BeeTee-EmBed/Icarus/Final Design (Icarus2019)/PCB Layout with traces.JPG

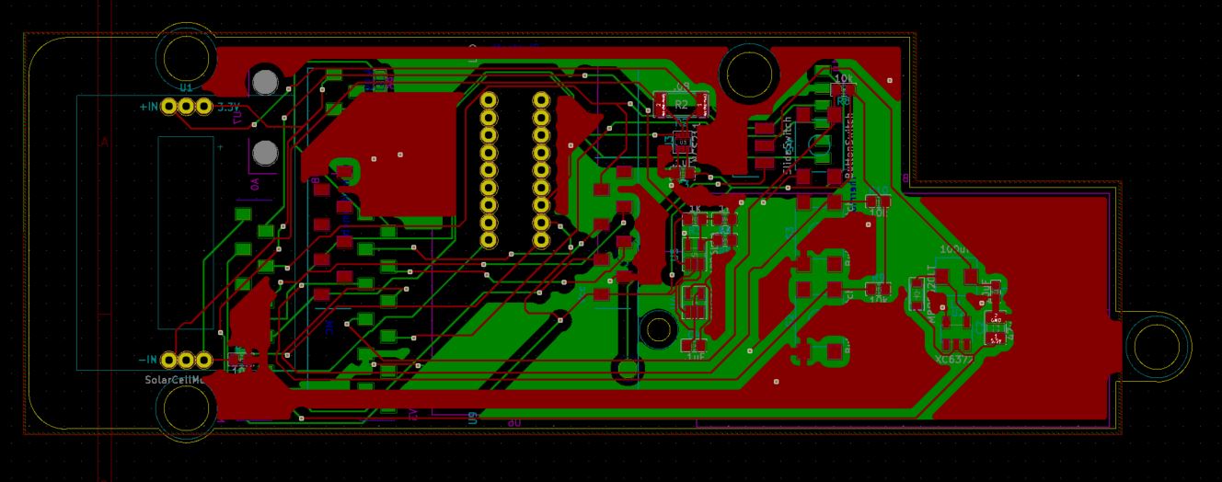
Final Design (Icarus2019)/PCB Layout with traces.JPG
