BeeTee-EmBed/Icarus/Final Design (Icarus2019)/3D view top.JPG

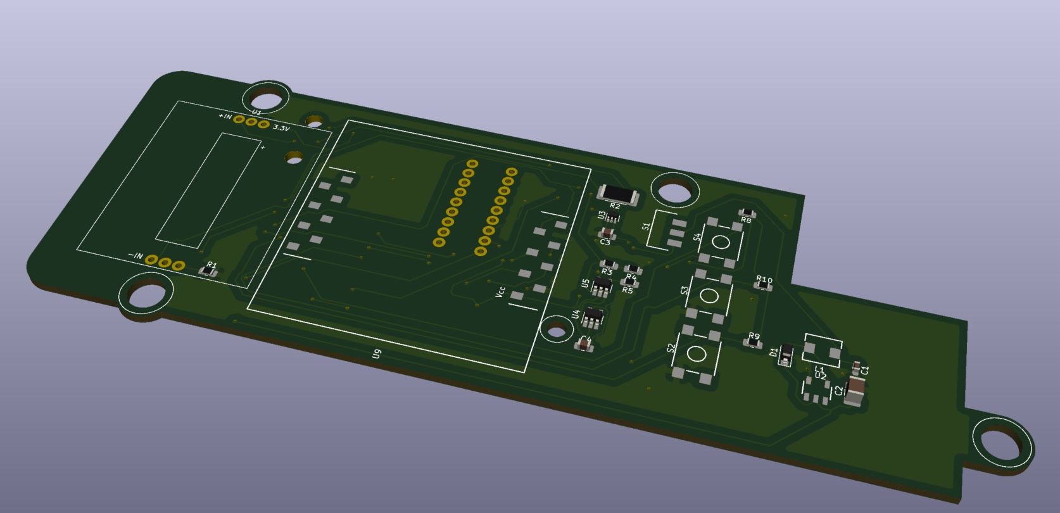
Final Design (Icarus2019)/3D view top.JPG
