BeeTee-EmBed/Icarus/Pin Out Specifications.xlsx

Accelerometer Pins | SDA -> D0
 | SDA -> D1
LCD Display | SCE -> A2
 | CLK -> A3
 | MOSI -> A5
 | D/C -> D2
 | RST -> D3
 | LED -> NA
 | Vcc -> 3V3
 | GND -> GND
Thermistor | Analog -> A0
Temp Sensor | Analog -> A1
Reference Cell | Analog -> DAC/A6
Thermocouple | CS -> WKP/A7
 | CLK -> A3
 | DO/MISO -> WKP
Buttons
Main | Digital -> D4
Temperature | Digital -> D5
Max/Angle | Digital -> D6
