BeeTee-EmBed/Icarus/Final Design (Icarus2019)/Icurus Error Analysis.xls

Sheet: 1 YEAR ANALYSIS
IRRADIANCE METER 1 YEAR ERROR ANALYSIS |  |  |  |  |  |  | 2019-08-07 |  | "STATISTICS IS NEVER HAVING TO SAY YOU'RE CERTAIN"
/evtfs/nfswkgrp/grponly/lepton/electrical/HRS/LEPTONerroranalysis.xls
ERROR MAGNITUDES ARE IN MAXIMUM +/-PPM EXCEPT WHERE NOTED IN RED ITALICS. MAXIMUM ERRORS ARE ROOT SUM SQUARED.
RED ITALICS | = | TYPICAL ERROR MAGNITUDES WHICH ARE ADDED TO THE ROOT SUM SQUARED ERRORS
 | = | PPM PER ROOT MONTH
 |  | INACCURACY |  | 12
 |  | OR NON- | TC | MONTH |  |  | Irradiance | Cell Temp | Ambien Temp | Inclinometer | Panel Temp
ERROR SOURCES |  | LINEARITY | PER DEG | STABILITY | HUMIDITY
VOLTAGE REFERENCE
REFERENCE |  | 30000 | 100 |  |  |  | 1 | 1 | 1 | 0 | 0
HYSTERESIS |  |  |  |  |  |  | 1 | 1 | 1 | 0 | 0
LOAD REGULATION/mA |  |  |  |  |  |  | 1 | 1 | 1 | 0 | 0
A/D CONVERTER
A/D CONVERTER |  | 1220 |  |  |  |  | 1 | 1 | 1 | 0 | 0
SOLAR CELL
Isc |  |  |  |  |  |  | 1 | 0 | 0 | 0 | 0
Temperature Coeffient |  |  |  |  |  |  | 1 | 0 | 0 | 0 | 0
SHUNT RESISTOR
80m ohms |  | 10000 | 50 | 200 | 400 |  | 1 | 0 | 0 | 0 | 0
INCLINOMETER
Angle Measurement |  | 26400 |  |  |  |  | 0 | 0 | 0 | 1 | 0
CURRENT SHUNT MONITOR
Gain 500 |  | 10000 | 10 |  |  |  | 1 | 0 | 0 | 0 | 0
 |  |  |  |  |  |  | 0 | 0 | 0 | 0 | 0
THERMISTOR
Resistance |  | 10000 |  |  |  |  | 1 | 1 | 0 | 0 | 0
B |  | 10000 |  |  |  |  | 1 | 1 | 0 | 0 | 0
THERMISTOR SERIES RESISTANCE
10k |  | 10000 | 100 | 200 | 400 |  | 1 | 1 | 1 | 0 | 0
TEMPERATURE SENSOR
Ambient Temperature |  | 160000 |  |  |  |  | 0 | 0 | 1 | 0 | 0
TEMPERATURE GAIN
R3 |  | 10000 | 100 | 200 | 400 |  | 0 | 0 | 1 | 0 | 0
R4 |  | 10000 | 100 | 200 | 400 |  | 0 | 0 | 1 | 0 | 0
R5 |  | 10000 | 100 | 200 | 400 |  | 0 | 0 | 1 | 0 | 0
THERMOCOUPLE
Panel Temperature |  |  |  |  |  |  | 0 | 0 | 0 | 0 | 1
INSTRUMENT CAPABILITY AT ONE |  |  |  |  | TEMPERATURE SHIFT | 10
YEAR AT 23+/-5 DEG C |  |  | ERRORS: |  |  | SUM | 8.50% | 6.38% | 24.01% | ±2.64% | ±2°C
 |  |  |  |  |  | RSS | 4.61% | 3.47% | 16.61%

Sheet: ERROR SOURCES
LEPTON ERROR ANALYSIS ERROR SOURCES
/evtfs/nfswkgrp/grponly/lepton/electrical/HRS/LEPTONerroranalysis.xls
 | PARAMETER | SOURCE
VOLTAGE REFERENCE | TC | LEO SPEC
 | STABILITY | 1 YEAR LEO TESTING
 | HYSTERESIS | LEO SPEC
 | LOAD REGULATION/mA | LEO SPEC
A/D CONVERTER | NON-LINEARITY | LEO SPEC
 | TC | LEO SPEC
SOLAR CELL | TC | Z1 SPEC
 | STABILITY | Z1 SPEC
 | HUMIDITY | Z1 SPEC
 | Temperature Coeffient | Z1 SPEC
SHUNT RESISTOR | TC | RESISTOR SPEC
 | STABILITY | BEN ENG'S 1 YEAR STABILITY TEST
 | HUMIDITY | HUMIDITY TEST
 | INCLINOMETER | Characterized, see lepton/electrical/freqresp/Rev5FreqResp.xls
 | Angle Measurement | Characterized, see lepton/electrical/freqresp/Rev5FreqResp.xls
CURRENT SHUNT MONITOR | NON-LINEARITY | LEO SPEC
 | TC | LEO SPEC
 | 0 | LEO SPEC
THERMISTOR | NON-LINEARITY | LEO SPEC
 | TC | LEO SPEC
 | STABILITY | 1 YEAR LEO TESTING
THERMISTOR SERIES RESISTANCE
10k | TC | RESISTOR SPEC
 | STABILITY | HISTORICAL & VENDOR TESTING
 | HUMIDITY | HISTORICAL & VENDOR TESTING
0 | TC | TESTING A MIZER SHUNT
 | STABILITY | AN ESTIMATE
 | 0 | TESTING A MIZER SHUNT
 | 0 | TESTING A MIZER SHUNT
TEMPERATURE SENSOR | NON-LINEARITY & TC | LEO SPEC
 | STABILITY | 1 YEAR LEO TESTING
TEMPERATURE GAIN | TC | LEO SPEC
 | STABILITY | 1 YEAR LEO TESTING
0 | TC | RESISTOR SPEC
 | STABILITY | BEN ENG'S 1 YEAR STABILITY TEST
 | HUMIDITY | HUMIDITY TEST
0 |  | VALIDARE TESTING

Sheet: MOHMS SENSITIVITY
LEPTON MOHMS SENSITIVITY | 20JUL05
/evtfs/nfswkgrp/grponly/lepton/electrical/HRS/LEPTONerroranalysis.xls
 |  | PPM |  | PPM |  | PPM
 |  | SHIFT |  | SHIFT |  | SHIFT
40 M OHMS
Is | 1e-07 | 1000 | 1.001e-07 | 0 | 1e-07 | 0 | 1e-07
Z1.10M NOMINAL | 10000000 | 0 | 10000000 | 1000 | 10010000 | 0 | 10000000
S64 NOMINAL | 1000 | 0 | 1000 | 0 | 1000 | 1000 | 1001
10M=Z1.10M+S64 | 10001000 |  | 10001000 |  | 10011000 |  | 10001001
Rx | 0 |  | 0 |  | 0 |  | 0
Vo=Is*Rx*(10M+S64)/(Rx+10M+S64) | 0.00000 |  | 0.00000 |  | 0.00000 |  | 0.00000
Vo, Rx+10k | 0.00100
uV/COUNT | 999.0
Rx=Vo*10M/(Is*10M-Vo) | 0 |  | 0 |  | 0 |  | 0
ERROR IN PPM |  |  | #DIV/0! |  | #DIV/0! |  | #DIV/0!
SENSITIVITY RATIO |  |  | #DIV/0! |  | #DIV/0! |  | #DIV/0!
