BeeTee-EmBed/Icarus/Final Design (Icarus2019)/3D view bottom.JPG

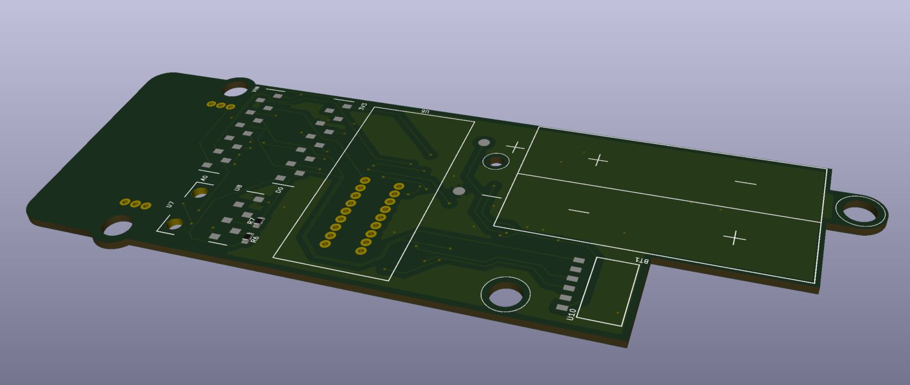
Final Design (Icarus2019)/3D view bottom.JPG
