BeeTee-EmBed/Icarus/Final Design (Icarus2019)/Case.png

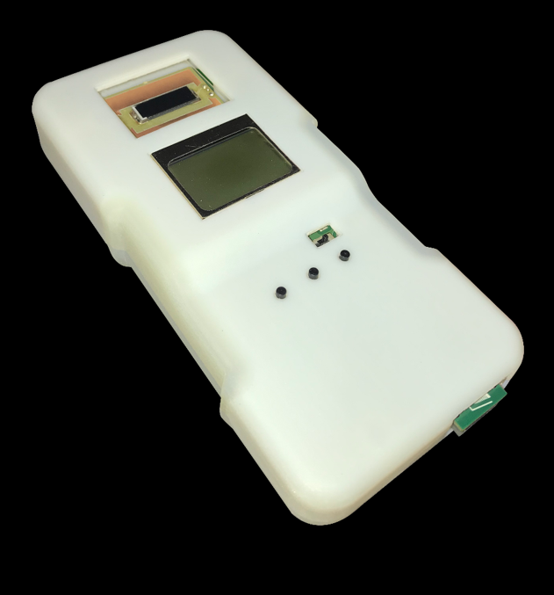
Final Design (Icarus2019)/Case.png
