BeeTee-EmBed/Icarus/Final Design (Icarus2019)/KiCad Schematic.JPG

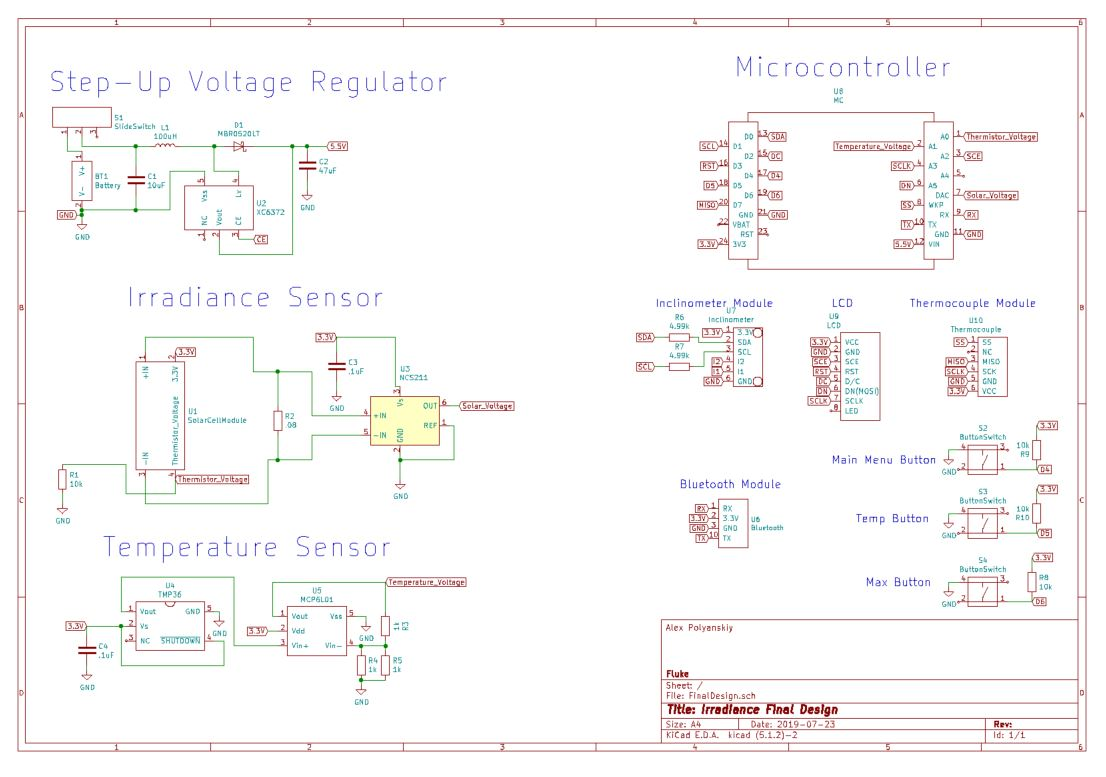
Final Design (Icarus2019)/KiCad Schematic.JPG
