BeeTee-EmBed/Icarus/Final Design (Icarus2019)/PCB Layout.JPG

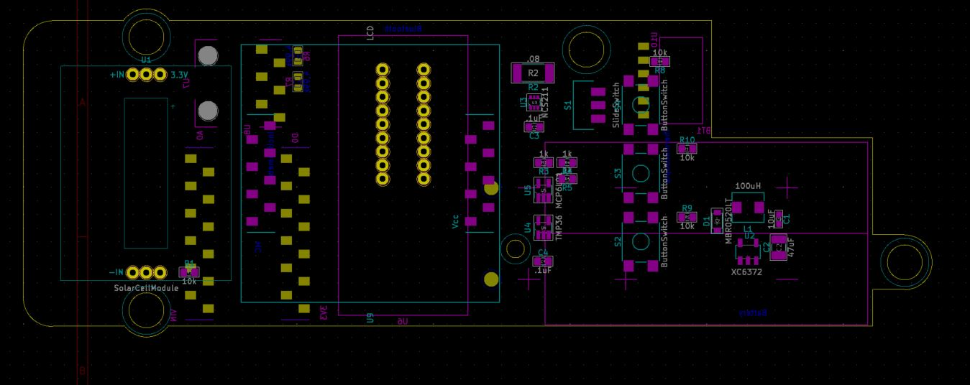
Final Design (Icarus2019)/PCB Layout.JPG
