BeeTee-EmBed/Icarus/First Design/Screenshots/3D PCB Layout.PNG

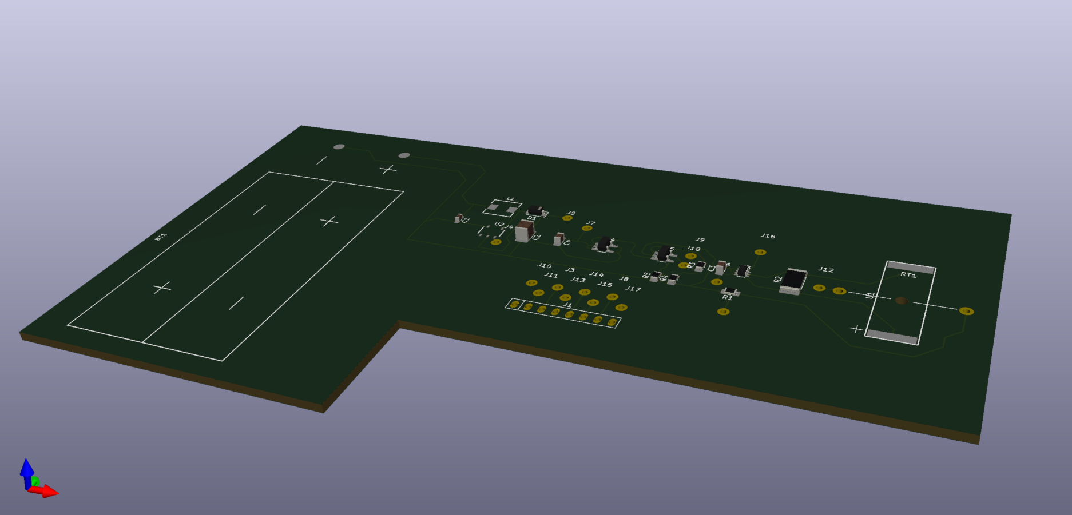
First Design/Screenshots/3D PCB Layout.PNG
