BeeTee-EmBed/Icarus/First Design/Screenshots/Built Circuit.jpg

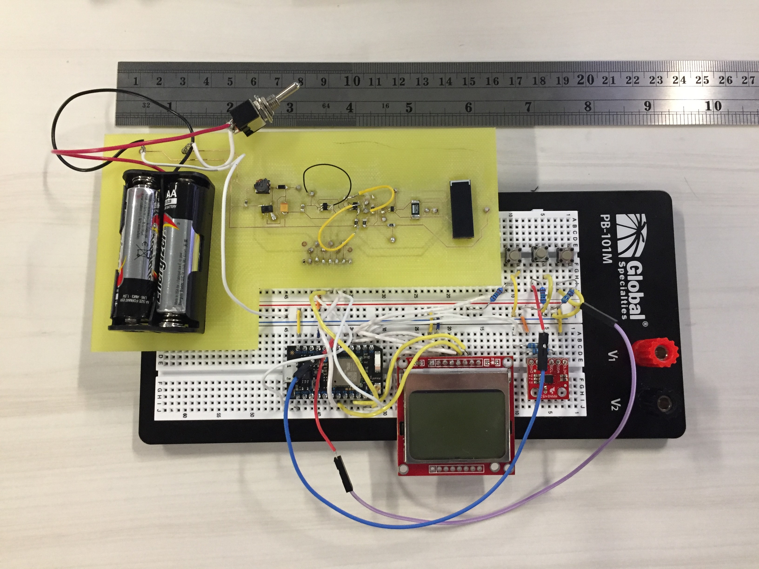
First Design/Screenshots/Built Circuit.jpg
