BeeTee-EmBed/Icarus/First Design/Screenshots/PCB Layout.PNG

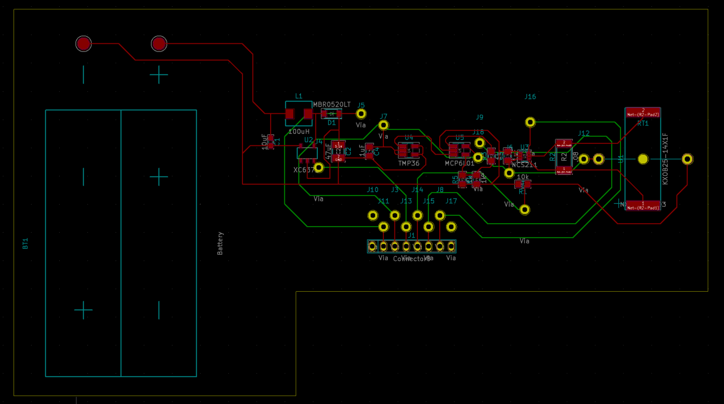
First Design/Screenshots/PCB Layout.PNG
