BeeTee-EmBed/Icarus/First Design/Screenshots/Prototype Schematic.PNG

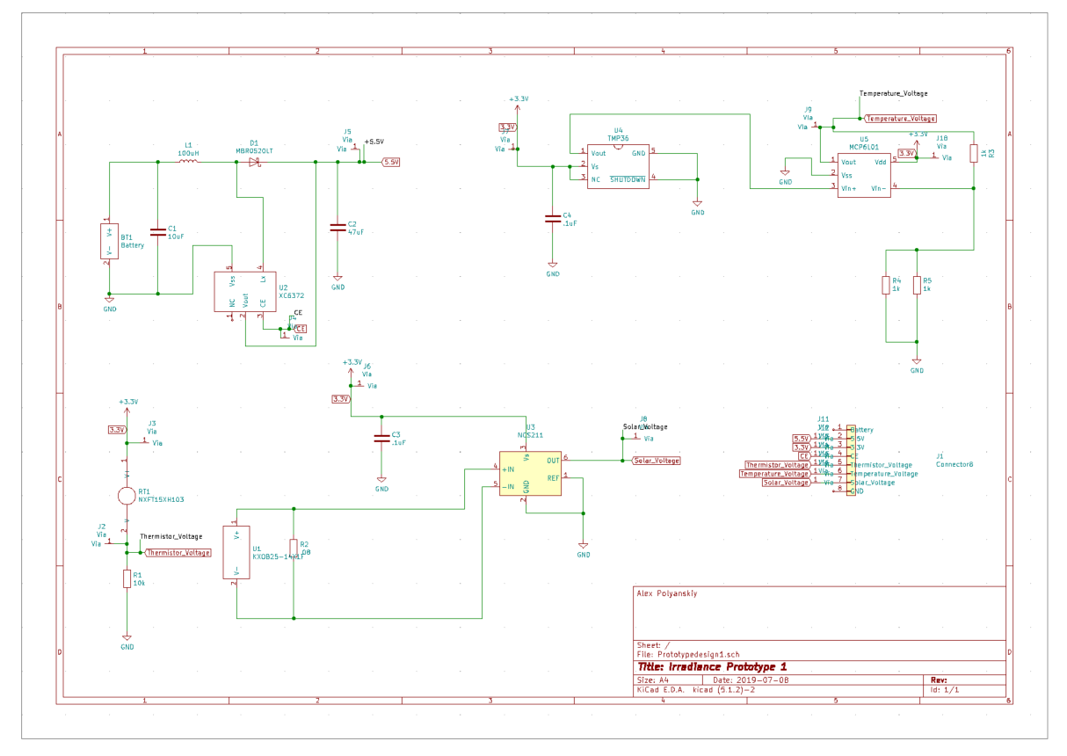
First Design/Screenshots/Prototype Schematic.PNG
