BeeTee-EmBed/Icarus/Irradiance Questions Answered by IEC/Email 1.JPG

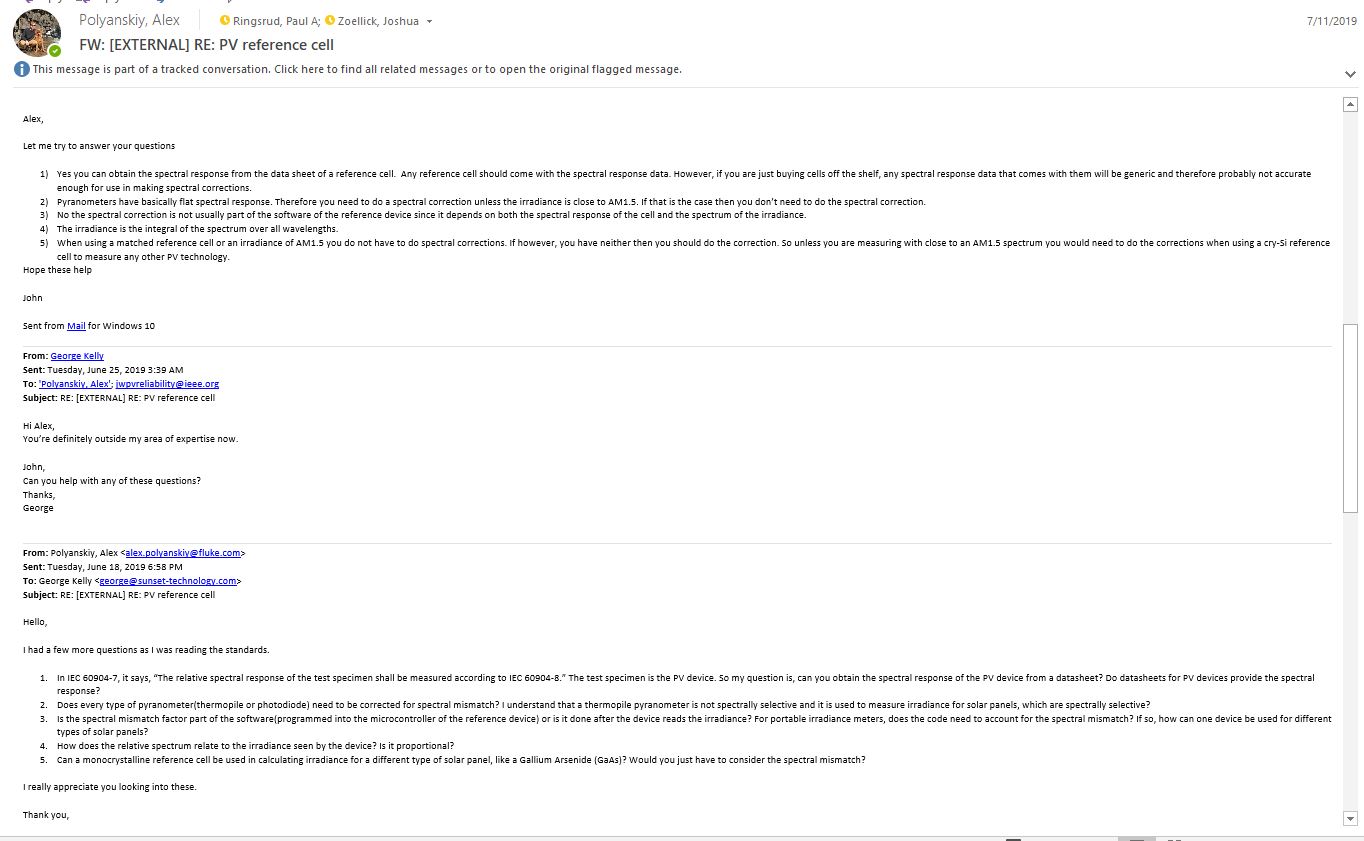
Irradiance Questions Answered by IEC/Email 1.JPG
