BeeTee-EmBed/Icarus/Irradiance Questions Answered by IEC/Email 2.JPG

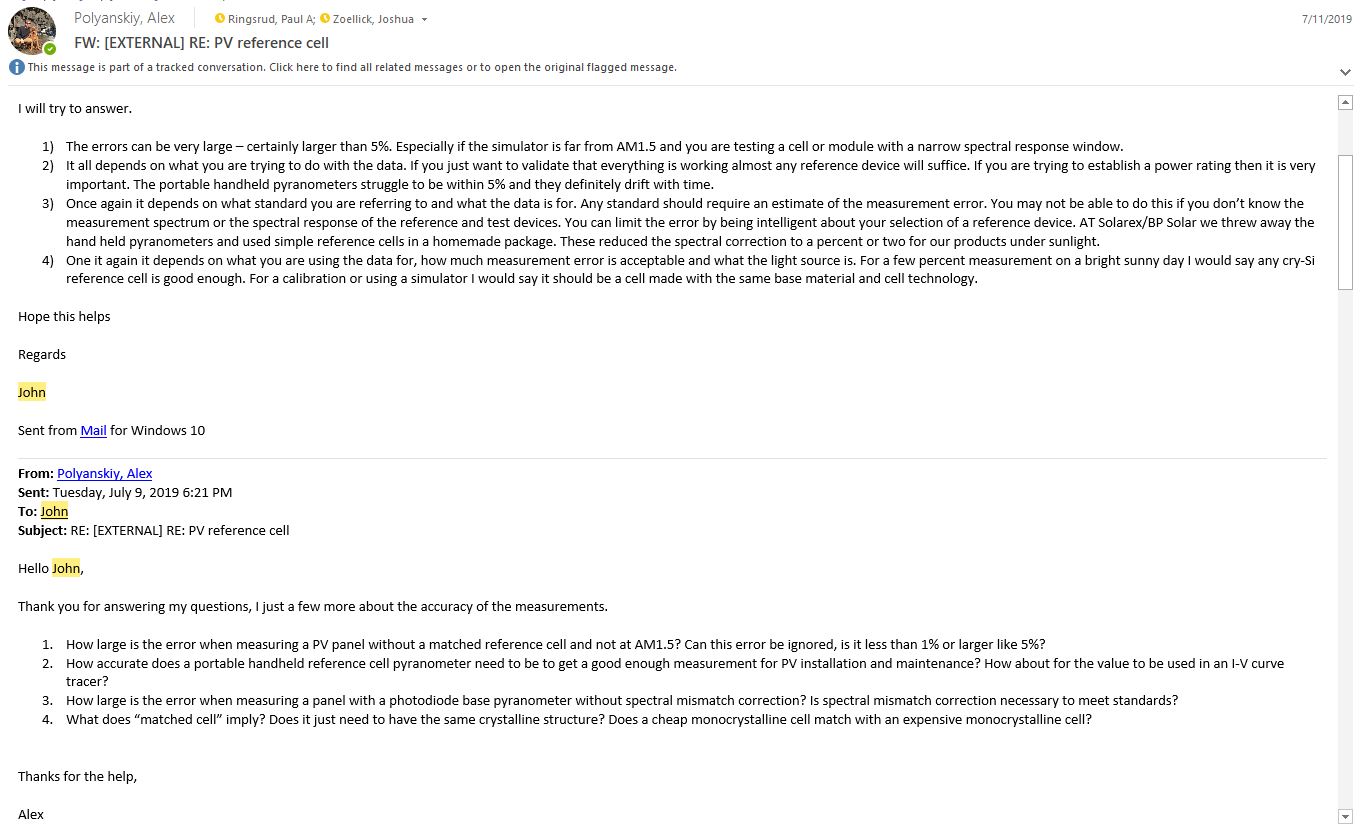
Irradiance Questions Answered by IEC/Email 2.JPG
