BeeTee-EmBed/Icarus/HardwareCost.xlsx

Part | Datasheet | Application | Cost | Quantity | Specs | Purchase Site | Note | Operating Current (mA) | Equations
KXOB25-14X1F-ND | Reference Cell Datasheet (http://ixapps.ixys.com/DataSheet/KXOB25-14X1F.pdf) | Solar Cell | $2.03 | 1 | Isc: 58mA Voc: 690mV Vmpp: 560mV Impp: 55mA Pmpp: 30.7mW FF: >70% Efficiency:25% Voc temp coefficient: -1.7 mV/K Isc temp coefficient: 26.5 uA/K | Digi-Key (https://www.digikey.com/product-detail/en/ixys/KXOB25-14X1F-TR/KXOB25-14X1FCT-ND/9990482) |  |  | Ee = effective irradiance Es = irradiance at standard conditions (1000w/m^2) Isc = measured short cicuit current Tc = cell temperature (found through thermistor) To = reference temperature (25 C) α = temperature coefficient for Isc (26.5 uA/C) Isco = reference short circuit current (58.6 mA)
BK7 glass | escooptics (https://escooptics.com/products/windows-commercial-quality-square-bk7-optical-glass?variant=19494881603) | Protective window for reference cell | $11.00 | 1 | 31.75mm x 31.75mm | escooptics (https://escooptics.com/products/windows-commercial-quality-square-bk7-optical-glass?variant=19494881603)
NXFT15XH103FA2B025 | NTC Thermistors Catalog (https://www.murata.com/~/media/webrenewal/support/library/catalog/products/thermistor/ntc/r44e.ashx?la=en-us) | Thermistor to measure solar cell temperature | $0.91 | 1 | Resistance in Ohms @ 25°C: 10k Resistance Tolerance: ±1% B Value Tolerance: ±1% | Digi-Key (https://www.digikey.com/products/en?keywords=490-5628-nd) |  | 0.077 | T = temperature of cell B = B-constant of themister (3380 K) To = reference tenmperature (25 C) R = resistiance at T Ro = resistance at To (10000 ohms) | R = resistance at T Vs = supply voltage (3.3V) Vth = thermistor voltage Rs = resistance of series resistor (10000 ohms)
‎TMP36GRTZ-REEL7CT-ND‎ | TMP35-37 (https://www.analog.com/media/en/technical-documentation/data-sheets/TMP35_36_37.pdf) | Temperature sensor for air temp | $1.77 | 1 | Output Type: Analog Voltage Voltage - Supply: 2.7V ~ 5.5V Resolution: 10mV/°C Accuracy - Highest (Lowest): ±3°C (±4°C) | Digi-Key (https://www.digikey.com/product-detail/en/TMP36GRTZ-REEL7/TMP36GRTZ-REEL7CT-ND/1140633/?itemSeq=295976317) |  | 0.05 | Ta = air temperature Vtemp = temperature voltage
MMA8452Q | MMA8452Q Datasheet (https://cdn.sparkfun.com/datasheets/Sensors/Accelerometers/MMA8452Q-rev8.1.pdf) | angle measurement | $9.95 | 1 |  | Digi-Key (https://www.digikey.com/product-detail/en/SEN-12756/1568-1028-ND/5140793/?itemSeq=296264821) |  | 0.165
‎1568-1349-ND‎ | LCD‐10168 (https://media.digikey.com/pdf/Data%20Sheets/Sparkfun%20PDFs/LCD%E2%80%9010168_Web.pdf) | LCD display | $9.95 | 1 |  | Digi-Key (https://www.digikey.com/product-detail/en/LCD-10168/1568-1349-ND/5764484/?itemSeq=295978829) |  | 7
865-XC6372C551PR-G | XC6372C551PR-G Datasheet (https://www.torexsemi.com/file/xc6372/XC6371-XC6372.pdf) | Voltage regulator, step up | $1.35 | 1 | Output Voltage: 5.5V Output Current: 100mA Input Voltage Max: 10V Input Voltage min: .9V | Mouser (https://www.mouser.com/ProductDetail/Torex-Semiconductor/XC6372C551PR-G) |  | 0.1338
MCP6L01RT-E/OTCT-ND | MCP6L01,1R,1U,2,4 (http://www.microchip.com/mymicrochip/filehandler.aspx?ddocname=en540137) | Op-amp for temp sensor | $0.26 | 1 | Output Type: Rail-to-Rail Slew Rate: 0.6V/µs Gain Bandwidth Product: 1MHz Current - Input Bias: 2pA Voltage - Input Offset: 1mV Current - Supply: 85µA | Digi-Key (https://www.digikey.com/product-detail/en/microchip-technology/MCP6L01RT-E-OT/MCP6L01RT-E-OTCT-ND/2060326) |  | 0.17
NCS211RSQT2GOSCT-ND | NCS21xR, NCV21xR (https://www.onsemi.com/pub/Collateral/NCS210R-D.PDF) | Current shunt monitoring amp | $0.85 | 1 | Output Type: Rail-to-Rail Slew Rate: 1V/µs -3db Bandwidth: 25kHz Current - Input Bias: 39µA Voltage - Input Offset: 550nV Current - Supply: 40µA Voltage - Supply, Single/Dual (±): 2.2V ~ 26V Gain: 500V/V | Digi-Key (https://www.digikey.com/product-detail/en/on-semiconductor/NCS211RSQT2G/NCS211RSQT2GOSCT-ND/10233515) |  | 0.1 | Isc = short circuit current Vsolar = measured voltage A = gain (500) Rsh = shunt resistance (.08 ohms)
P10.0KCCT-ND | ERJ Series, Precision Resistor Datasheet (https://industrial.panasonic.com/cdbs/www-data/pdf/RDA0000/AOA0000C304.pdf) | 10k resistor for thermistor size: 805 | $0.10 | 4 | Resistance: 10 kOhms Tolerance: ±1% Power (Watts): 0.125W, 1/8W Composition: Thick Film Temperature Coefficient: ±100ppm/°C | Digi-Key (https://www.digikey.com/product-detail/en/panasonic-electronic-components/ERJ-6ENF1002V/P10.0KCCT-ND/119248)
RNCP0805FTD1K00CT-ND | RNCP Series (https://www.seielect.com/catalog/sei-rncp.pdf) | 1k resistor for temp sensor size: 805 | $0.10 | 3 | Resistance: 1 kOhms Tolerance: ±1% Power (Watts): 0.25W, 1/4W Composition: Thin Film Temperature Coefficient: ±100ppm/°C | Digi-Key (https://www.digikey.com/product-detail/en/stackpole-electronics-inc/RNCP0805FTD1K00/RNCP0805FTD1K00CT-ND/2240568)
YAG2158CT-ND | PExL Series Datasheet (http://www.yageo.com/NewPortal/yageodocoutput?fileName=/pdf/R-Chip/PYu-PE_521_RoHS_L_5.pdf) | .08 resistor shunt size: 2512 | $0.65 | 1 | Resistance: 80 mOhms Tolerance: ±1% Power (Watts): 1W Composition: Metal Foil Temperature Coefficient: ±50ppm/°C | Digi-Key (https://www.digikey.com/product-detail/en/yageo/PE2512FKE070R08L/YAG2158CT-ND/5139606)
478-3352-1-ND | X7R Dielectric Capacitor Series (http://datasheets.avx.com/X7RDielectric.pdf) | .1uF for bypass for current shunt monitor and temp sensor size: 805 | $0.22 | 3 | Capacitance: 0.1µF Tolerance: ±5% Voltage - Rated: 50V | Digi-Key (https://www.digikey.com/product-detail/en/avx-corporation/08055C104JAT2A/478-3352-1-ND/930144)
‎36-2463-ND‎ | 2463 Drawing (http://www.keyelco.com/product-pdf.cfm?p=1028) | Battery holder (2AA) | $1.21 | 1 |  | Digi-Key (https://www.digikey.com/product-detail/en/2463/36-2463-ND/303812/?itemSeq=295980397)
732-5319-ND | 6130xx11121 Drawing (https://katalog.we-online.de/em/datasheet/6130xx11121.pdf) | Headers | $0.33 | 1 |  | Digi-Key (https://www.digikey.com/product-detail/en/wurth-electronics-inc/61300611121/732-5319-ND/4846833)
308-2207-1-ND | CR54 (https://media.digikey.com/pdf/Data%20Sheets/Sumida%20PDFs/CR54_Series.pdf) | Inductor of voltage regulator 5.8x5.3mm | $0.89 | 1 | Inductance: 100µH Tolerance: ±10% Current Rating (Amps): 520mA | Digi-Key (https://www.digikey.com/product-detail/en/sumida-america-components-inc/CR54NP-101KC/308-2207-1-ND/3947430)
MBR0520LT1GOSCT-ND | MBR0520LT1, T3 (http://www.onsemi.com/pub/Collateral/MBR0520LT1-D.PDF) | Diode for voltage regulator | $0.38 | 1 | Diode Type: Schottky Voltage - DC Reverse (Vr) (Max): 20V Current - Average Rectified (Io): 500mA Voltage - Forward (Vf) (Max) @ If: 385mV @ 500mA | Digi-Key (https://www.digikey.com/product-detail/en/on-semiconductor/MBR0520LT1G/MBR0520LT1GOSCT-ND/917965)
478-3891-1-ND | TAJ Series, Standard (http://datasheets.avx.com/TAJ.pdf) | Tantalum capacitor for voltage regulator 1210 | $0.56 | 1 | Capacitance: 47µF Tolerance: ±20% Voltage - Rated: 10V | Digi-Key (https://www.digikey.com/product-detail/en/avx-corporation/TAJB476M010RNJ/478-3891-1-ND/1126937)
LMK107BJ106MALTD | Multilayer Ceramic Capacitor Catalog (https://www.yuden.co.jp/productdata/catalog/mlcc01_e.pdf) | Aluminum capacitor for voltage regulator 603 | $0.50 | 1 | Capacitance: 10µF Tolerance: ±20% Voltage - Rated: 10V | Digi-Key (https://www.digikey.com/product-detail/en/taiyo-yuden/LMK107BJ106MALTD/587-2562-1-ND/2269355)
PRPC015SACN-RC | zzzCzzzSzzN-RC Drawing (https://media.digikey.com/PDF/Data%20Sheets/Sullins%20PDFs/xRxCzzzSxxN-RC_ST_11635-B.pdf) | Headers | $0.50 | 1 |  | Digi-Key (https://www.digikey.com/product-detail/en/sullins-connector-solutions/PRPC015SACN-RC/S1131EC-15-ND/2776091)
Photon MC | Photon Datasheet (https://docs.particle.io/datasheets/photon-(wifi)/photon-datasheet/) | Microcontroller | $19.28 | 1 |  | Digi-Key (https://www.digikey.com/product-detail/en/particle-industries-inc/PHOTONH/1878-1000-ND/7896991) |  | 40
BT832 BLE5 Module | BT832(A,F,AF)* (https://media.digikey.com/pdf/Data%20Sheets/Fanstel%20PDFs/BT832_A_F_AF_V2.04_Dec-2017.pdf) | Bluetooth Module | $9.53 | 1 |  | Digi-Key (https://www.digikey.com/product-detail/en/fanstel-corp/BT832/1914-1013-1-ND/8323666?%20RFID) |  | 7.5
MAX31855PMB1 | MAX31855PMB1 (https://datasheets.maximintegrated.com/en/ds/MAX31855PMB1.pdf) | Thermocouple Module | $21.23 | 1 | dimensions: 2.125in x .8in x .0625in | Digi-Key (https://www.digikey.com/product-detail/en/maxim-integrated/MAX31855PMB1/MAX31855PMB1-ND/3758888) |  | 1.5
JS202011SCQN | JS Series Slide Datasheet (https://www.ckswitches.com/media/1422/js.pdf) | On/ Off switch | $0.48 | 1 |  | Digi-Key (https://www.digikey.com/products/en?keywords=401-2002-1-nd)
NPTC121KFXC-RC | NPxCxx1KFXx-RC (https://media.digikey.com/pdf/Data%20Sheets/Sullins%20PDFs/NPxCxx1KFXx-RC%2010487-D.pdf) | Surface mount connector for microcontroller | $1.42 | 2 |  | Digi-Key (https://www.digikey.com/product-detail/en/sullins-connector-solutions/NPTC121KFXC-RC/S5604-ND/776062)
NPTC081KFXC-RC | NPxCxx1KFXx-RC (https://media.digikey.com/pdf/Data%20Sheets/Sullins%20PDFs/NPxCxx1KFXx-RC%2010487-D.pdf) | Surface mount connector for LCD | $1.20 | 2 |  | Digi-Key (https://www.digikey.com/product-detail/en/sullins-connector-solutions/NPTC081KFXC-RC/S5600-ND/776058)
NPTC061KFXC-RC | NPxCxx1KFXx-RC (https://media.digikey.com/pdf/Data%20Sheets/Sullins%20PDFs/NPxCxx1KFXx-RC%2010487-D.pdf) | Surface mount connector for inclinometer | $0.91 | 1 |  | Digi-Key (https://www.digikey.com/product-detail/en/sullins-connector-solutions/NPTC061KFXC-RC/S5598-ND/776056)
M20-7910642R | M20-791xx42R Drawing (https://cdn.harwin.com/pdfs/M20-791R.pdf) | Surface mount connector for thermocouple module | $1.08 | 1 |  | Digi-Key (https://www.digikey.com/products/en?keywords=952-3199-1-nd)
RNCP0805FTD4K99 | RNCP Series (https://www.seielect.com/catalog/sei-rncp.pdf) | Resistors for inclinometer | $0.10 | 2 |  | Digi-Key (https://www.digikey.com/products/en?keywords=rncp0805ftd4k99ct-nd)
MJTP1138BTR | MJTP Series (https://media.digikey.com/pdf/Data%20Sheets/APEM%20Components%20PDFs/MJTP%20Series.pdf) | Switch | $0.65 | 3 |  | Digi-Key (https://www.digikey.com/products/en?keywords=679-2415-1-nd)
PPPC031LFBN-RC | xPxCyyyLFBN-RC Drawing (https://drawings-pdf.s3.amazonaws.com/10492.pdf) | Through hole mount for solar cell module | $0.37 | 2 |  | Digi-Key (https://www.digikey.com/product-detail/en/sullins-connector-solutions/PPPC031LFBN-RC/S7036-ND/810175)
 |  | Total Cost ($): | 94.49 |  |  |  | Total Current (mA): | 56.6958
