BeeTee-EmBed/Icarus/DC combiner box Research/DC Combiner Box Sheet.xlsx

Brand | Model | Voltage Rating | Current Rating (Disconnect current) | Number of Fuses | Fuse Current Rating | Temperature Range | Warranty | Datasheet
Bentek | BTKv‒UTS | 1000 VDC | 200-400 A | 6-14 | 15-30 A | up to 50C |  | Datasheet (https://www.bentek.com/wp-content/uploads/ds/991-003869-000-F_Bentek-1000V-UTS-Combiner-Grounded-DS.pdf)
Yaskawa | XGI 1500 | 1500 VDC | 250 A | 16-28 | 15-30 A | -40C - 50C | 5 years | XGI 1500 COMBINERS (pdf) (https://www.solectria.com/support/documentation/string-combiners/xgi-1500-combiners/)
Yaskawa | DISCOM 1000 | 1000 VDC | 96-360 A | 8-30 | 15-20 A | -40C - 50C | 5 years | DISCOM Disconnecting String Combiner Datasheet (pdf) (https://www.solectria.com/support/documentation/string-combiners/discom-3r-discom-4-discom-4m-disconnecting-string-combiner-datasheet/)
ABB | String Combiner 1000V DC | 1000 VDC | 10-320 A | 1-32 | 15 A | -20C - 50C |  | pdf (https://search-ext.abb.com/library/Download.aspx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)
ABB | String Combiner 1000V DC | 1500 VDC | 160-320 A | 16-32 | 15 A | -20C - 50C |  | pdf (https://search-ext.abb.com/library/Download.aspx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)
Connect PV | 1500V Combiner | 1500 VDC | 250-400 A | 16-32 | 15 A |  | 5 years | Datasheet
Connect PV | Standard Combiner | 1000 VDC | 100-400 A | 8-32 | 15 A |  | 5 years | Datasheet
First Solar | Series 6 | 1500 VDC | 125-419 A | 12-20 | 20-32 A | -20C - 45C |  | Datasheet
EAST | EAPVCB16HV | 1500 VDC | 160 A | 16 | 15 A | -30C - 65C |  | Datasheet (http://www.eastups.com/en/products_show_42_46_237.html)
Shoals | 1500V Series | 1500 VDC | 250-400 A | 12-24 | 24 A |  | 5 years | Datasheet (https://www.shoals.com/combiner)
 |  |  |  | Most of the time fuses are used instead of breakers due to cost and voltage rating. Breakers are used in lower voltage strings such as 150 VDC.
