BeeTee-EmBed/Icarus/Solar Panel Research/solar panel specs.xlsx

Brand | Model | System Rating (V) | Efficiency (%) | Cell Type | Cell Count | Max Power (W) | Vmmpp(V) and Impp(A) at certain power(W) | Voc(V) at certain power(W) | Isc(A) at certain power(W) | Operating Temperature | Max Series Fuse(A) | Max Warrenty (years) | Datasheet
LG | LGXXXN1C-V5 | 1000 | 19.6/19.8 | Monocrystaline (N-type) | 60 | 340/335 | Vmpp: 34.5 Impp: 9.86 @ Pm: 340 | 41.1 @ 340 | 10.53 @ 340 | -40C - 90C | 20 | 25 | Datasheet (https://www.wholesalesolar.com/cms/specs-20190408194947.1524633.pdf)
LG | LGXXXQ1C-A5 | 1000 | 20.3-21.1 | Monocrystaline (N-type) | 60 | 350-365 | Vmpp: 36.7 Impp: 9.95 @ Pm: 365 | 42.8 @ 365 | 10.8 @ 365 | -40C - 90C | 20 | 25 | Datasheet (https://www.wholesalesolar.com/cms/specs-2721919035.1524750.pdf)
LG | LGXXXN2W-A5 | 1500 | 19.1-19.8 | Monocrystaline (N-type) | 72 | 395-410 | Vmpp: 41.4 Impp: 9.91 @ Pm: 410 | 49.5 @ 410 | 10.55 @ 410 | -40C - 90C | 20 | 12 | Datasheet (https://www.wholesalesolar.com/cms/lg-lg-solar-400-neon2-mono-silver-frame-module-lg-400n2w-a5-40mm-frame-commercial-only-solar-panel-specs-4006621630.1524800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)
SunPower | SPR-P17-XXX-COM | 1000 | 16-17 | Multicrystaline | rows | 330-350 | Vmpp: 43.1 Impp: 8.12 @ Pm: 350 | 51.7 @ 350 | 8.65 @ 350 | -40C - 85C | 15 | 25 | Datasheet (https://us.sunpower.com/sites/default/files/media-library/data-sheets/ds-sunpower-p17-355-commercial-solar-panels.pdf)
SunPower | SPR-P17-XXX-COM | 1500 | 16.2-17.2 | Multicrystaline | rows | 335-355 | Vmpp: 43.1 Impp: 8.12 @ Pm: 350 | 51.7 @ 350 | 8.65 @ 350 | -40C - 85C | 15 | 25 | Datasheet (https://us.sunpower.com/sites/default/files/media-library/data-sheets/ds-sunpower-p17-355-1500v-commercial-solar-panels.pdf)
SunPower | SPR-EXX-XXX | 600/1000 | 19.9-20.4 | Monocrystalline Maxeon Gen II | 96 | 320-327 | Vmpp: 54.7 Impp: 5.86 @ Pm: 320 | 64.8 @ 320 | 6.24 @ 320 | -40C - 85C | 15 | 25 | Datasheet (https://us.sunpower.com/sites/default/files/media-library/data-sheets/ds-e20-series-327-residential-solar-panels.pdf)
SunPower | SPR-X21-XXX | 600/1000 | 21-21.5 | Monocrystalline Maxeon Gen II | 96 | 335-345 | Vmpp: 57.3 Impp: 6.02 @ Pm: 345 | 68.2 @ 345 | 6.39 @ 345 | -40C - 85C | 15 | 25 | Datasheet (https://us.sunpower.com/sites/default/files/media-library/data-sheets/ds-x21-series-335-345-residential-solar-panels.pdf)
Panasonic | VBHNXXXSA17 (HIT) | 600 | 19.4-20.3 | Amorphous silicon layers | 96 | 335-340 | Vmpp: 59.7 Impp: 5.7 @ Pm: 340 | 71.3 @ 340 | 6.13 @ 340 | -40C - 85C | 15 | 25 | Datasheet
CanadianSolar | CS3L-XXXP (HiKu) | 1000/1500 | 17.84-18.65 | Poly-crystalline | 120 | 330-345 | Vmpp: 32.6 Impp: 10.52 @ Pm: 340 | 39.6 @ 340 | 10.98 @ 340 | -40C - 85C | 20 | 25 | Datasheet (https://www.canadiansolar.com/upload/59b033fde6dc9adc/9a91a18310512b9c.pdf)
CanadianSolar | CS3W-XXXP (HiKu) | 1000/1500 | 17.88-18.79 | Poly-crystalline | 144 | 395-415 | Vmpp: 39.1 Impp: 10.49 @ Pm: 410 | 47.8 @ 410 | 11.06 @ 410 | -40C - 85C | 20 | 25 | Datasheet (https://www.canadiansolar.com/upload/55bb2d3819da47c6/0ac3c8f850d7224a.pdf)
CanadianSolar | CS6U-XXXP (MAXPOWER) | 1000/1500 | 16.72-18.26 | Poly-crystalline | 72 | 325-355 | Vmpp: 37.6 Impp: 9.05 @ Pm: 340 | 45.9 @ 340 | 9.62 @ 340 | -40C - 85C | 20 | 25 | Datasheet (https://www.canadiansolar.com/upload/9f6474e3a7c4881c/d421046f5307ed4c.pdf)
CanadianSolar | CS6K-XXXP (Standard) | 1000/1500 | 16.5-18.63 | Poly-crystalline | 60 | 270-305 | Vmpp: 32 Impp: 9.38 @ Pm: 300 | 38.8 @ 300 | 9.92 @ 300 | -40C - 85C | 20 | 25 | Datasheet (https://www.canadiansolar.com/upload/a1154b5d373f70f1/ffb476f06f2c4768.pdf)
CanadianSolar | CS6K-XXXMS (Standard) | 1000/1500 | 18.33-19.24 | Mono-crystalline | 60 | 300-315 | Vmpp: 32.5 Impp: 9.24 @ Pm: 300 | 39.7 @ 300 | 9.83 @ 300 | -40C - 85C | 20 | 25 | Datasheet (https://www.canadiansolar.com/upload/b90b2b198796e800/9c1943691b94c57b.pdf)
Hyundai | HiA-SXXXRG | 1000 | 18.44 | Mono-crystalline | 60 | 300 | Vmpp: 39.72 Impp: 9.74 @ Pm: 300 | 39.72 @ 300 | 9.72 @ 300 | -40C - 85C | 20 | 30 | Datasheet (https://www.hyundaisolar.com.au/wp-content/uploads/2019/04/RG-SERIES_Datasheet_MONO-60CELL-MAR2019.pdf)
Hyundai | HiA-S360Rl | 1000 | 18.55 | Mono-crystalline | 72 | 360 | Vmpp: 47.44 Impp: 9.73 @ Pm: 360 | 47.44 @ 360 | 9.73 @ 360 | -40C - 85C | 20 | 30 | Datasheet (https://www.hyundaisolar.com.au/wp-content/uploads/2019/04/RI-SERIES_Datasheet_MONO-72CELL-MAR2019.pdf)
TrinaSolar | ALLMAX M PLUS | 1000 | 16.8-19.2 | Mono-crystalline | 60 | 275-315 | Vmpp: 32.6 Impp: 9.19 @ Pm: 300 | 39.8 @ 300 | 9.77 @ 300 | -40C - 85C | 20 | 25 | Datasheet (https://static.trinasolar.com/sites/default/files/PS-M-0421%20Datasheet_Allmax%20M%20Plus_US_Apr2018_C.pdf)
TrinaSolar | TALLMAX M PLUS | 1500 | 17.5-19.5 | Mono-crystalline | 72 | 340-380 | Vmpp: 38.7 Impp: 9.04 @ Pm: 350 | 47.0 @ 350 | 9.60 @ 350 | -40C - 85C | 20 | 25 | Datasheet (https://static.trinasolar.com/sites/default/files/Datasheet_Tallmax_1500V%20M%20Plus_2019_May.pdf)
TrinaSolar | TALLMAX M PLUS Half-Cut | 1500 | 17.4-19.9 | Mono-crystalline | 144 | 345-395 | Vmpp: 38.4 Impp: 9.13 @ Pm: 350 | 46.5 @ 350 | 9.60 @ 350 | -40C - 85C | 20 | 25 | Datasheet (https://static.trinasolar.com/sites/default/files/Datasheet_DE14H%28II%29_HC_1500V_May2019_NT.pdf)
TrinaSolar | ALLMAX | 1000 | 16.2-17.4 | Multicrystalline | 60 | 265-285 | Vmpp: 31.4 Impp: 8.92 @ Pm: 280 | 38.2 @ 280 | 9.40 @ 280 | -40C - 85C | 15 | 25 | Datasheet (https://static.trinasolar.com/sites/default/files/PS-M-0323%20Datasheet_Allmax_US_Apr2018_C.pdf)
TrinaSolar | TALLMAX | 1000 | 16.5-17.5 | Multicrystalline | 72 | 320-340 | Vmpp: 37.8 Impp: 8.99 @ Pm: 340 | 46.2 @ 340 | 9.42 @ 340 | -40C - 85C | 15 | 25 | Datasheet (https://static.trinasolar.com/sites/default/files/PS-M-0328%20Datasheet_Tallmax_2018_B_0.pdf)
TrinaSolar | TALLMAX 1500V | 1500 | 16.5-17.5 | Multicrystalline | 72 | 320-340 | Vmpp: 37.8 Impp: 8.99 @ Pm: 340 | 46.2 @ 340 | 9.42 @ 340 | -40C - 85C | 15 | 25 | Datasheet (https://static.trinasolar.com/sites/default/files/PS-M-0353%20Datasheet_Tallmax_1500V_2018_B.pdf)
First Solar | Series 4 | 1500 | 15.3-17.0 | Thin-film CdTe | 216 | 110-122.5 | Vmpp: 70.8 Impp: 1.70 @ Pm: 120 | 88.7 @ 120 | 1.84 @ 120 | -40C - 85C | 4 | 25 | Datasheet (http://www.firstsolar.com/-/media/First-Solar/Technical-Documents/Series-4-Datasheets/Series-4V3-Module-Datasheet.ashx)
First Solar | Series 6 | 1500 | 17-18 | Thin-film CdTe | 264 | 420-445 | Vmpp: 185.7 Impp: 2.4 @ Pm: 445 | 220.4 @ 445 | 2.56 @ 445 | -40C - 85C | 6 | 25 | Datasheet (http://www.firstsolar.com/-/media/First-Solar/Technical-Documents/Series-6-Datasheets/Series-6-Datasheet.ashx)
Solar Frontier | SFK180-S | 1500 |  | CIS substrate glass (Cadmium free) |  | 180 | Vmpp: 92.4 Impp: 1.95 @ Pm: 180 | 120 @ 180 | 2.18 @ 180 | -40C - 85C | 4 |  | Datasheet (http://www.solar-frontier.com/eng/solutions/products/pdf/SAB12-0744_01_Product_Data_Sheet_SFK180-S.PDF)
