BeeTee-EmBed/Icarus/(list of files, drawings)

Other design files:
MIscellaneous Files/ICARUS.DSN
