BeeTee-EmBed/Icarus/First Design/KiCad Files/Prototypedesign1/Prototypedesign1.kicad_pcb

## KiCad design First Design/KiCad Files/Prototypedesign1/Prototypedesign1.kicad_pcb (2019-08-20)

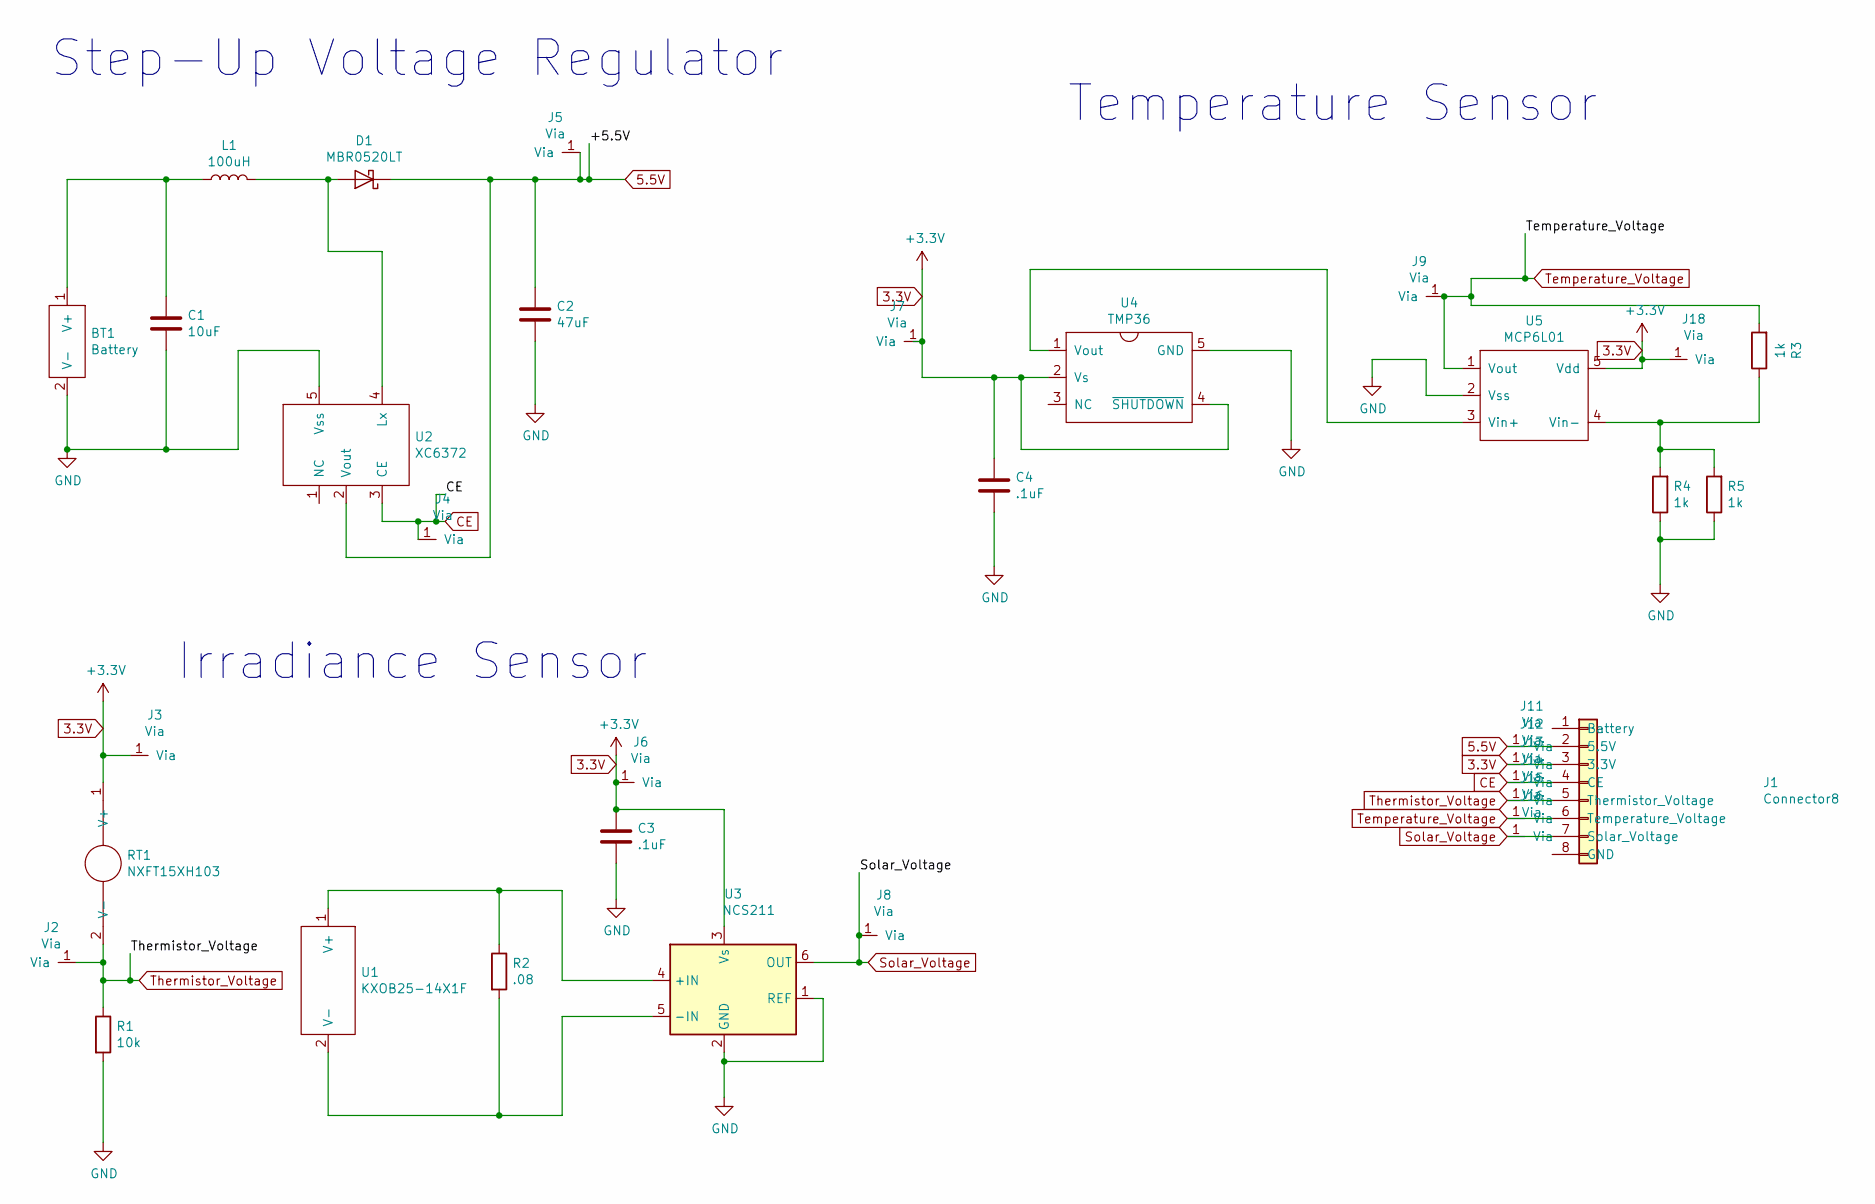
[picture p36: schematic Prototypedesign1.sch, Irradiance Prototype 1]

Parts:
BT1: Battery; Prototypebatteryholder
C1: 10uF; C_0603_1608Metric_Pad1.05x0.95mm_HandSolder
C2: 47uF; C_1210_3225Metric_Pad1.42x2.65mm_HandSolder
C3, C4: .1uF; C_0805_2012Metric_Pad1.15x1.40mm_HandSolder
D1: MBR0520LT; D_SOD-123
J1: Connector8; SIP-8
J2, J3, J4, J5, J6, J7, J8, J9, J11, J12, J13, J14, J15, J16, J18: Via
L1: 100uH; Inductor100uH
R1: 10k; R_0805_2012Metric_Pad1.15x1.40mm_HandSolder
R2: .08; R_2512_6332Metric_Pad1.52x3.35mm_HandSolder
R3, R4, R5: 1k; R_0805_2012Metric_Pad1.15x1.40mm_HandSolder
RT1: NXFT15XH103; Thermistor
U1: KXOB25-14X1F; KXOB25
U2: XC6372
U3: NCS211; SOT-363_SC-70-6
U4: TMP36; SOT-23-5_HandSoldering-TMP36
U5: MCP6L01; SOT-23-5_HandSoldering-MCP6L01

Connections:
3.3V: C3.1, C4.1, J1.3 (3.3V), J3.1, J6.1, J7.1, J12.1, J18.1, RT1.1 (V+), U3.3 (Vs), U4.2 (Vs), U4.4 (~SHUTDOWN), U5.5 (Vdd)
5.5V: C2.1, D1.1 (K), J1.2 (5.5V), J5.1, J11.1, U2.2 (Vout)
CE: J1.4 (CE), J4.1, J13.1, U2.3 (CE)
GND: BT1.2 (V-), C1.2, C2.2, C3.2, C4.2, R1.2, R4.1, R5.1, U2.5 (Vss), U3.1 (REF), U3.2 (GND), U4.5 (GND), U5.2 (Vss)
unnamed: BT1.1 (V+), C1.1, L1.1
unnamed: D1.2 (A), L1.2, U2.4 (Lx)
unnamed: R2.1, U1.1 (V+), U3.4 (+IN)
unnamed: R2.2, U1.2 (V-), U3.5 (-IN)
unnamed: R3.1, R4.2, R5.2, U5.4 (Vin-)
unnamed: U4.1 (Vout), U5.3 (Vin+)
Solar_Voltage: J1.7 (Solar_Voltage), J8.1, J16.1, U3.6 (OUT)
Temperature_Voltage: J1.6 (Temperature_Voltage), J9.1, J15.1, R3.2, U5.1 (Vout)
Thermistor_Voltage: J1.5 (Thermistor_Voltage), J2.1, J14.1, R1.1, RT1.2 (V-)

Notes on the sheet:
Step-Up Voltage Regulator
Irradiance Sensor
Temperature Sensor

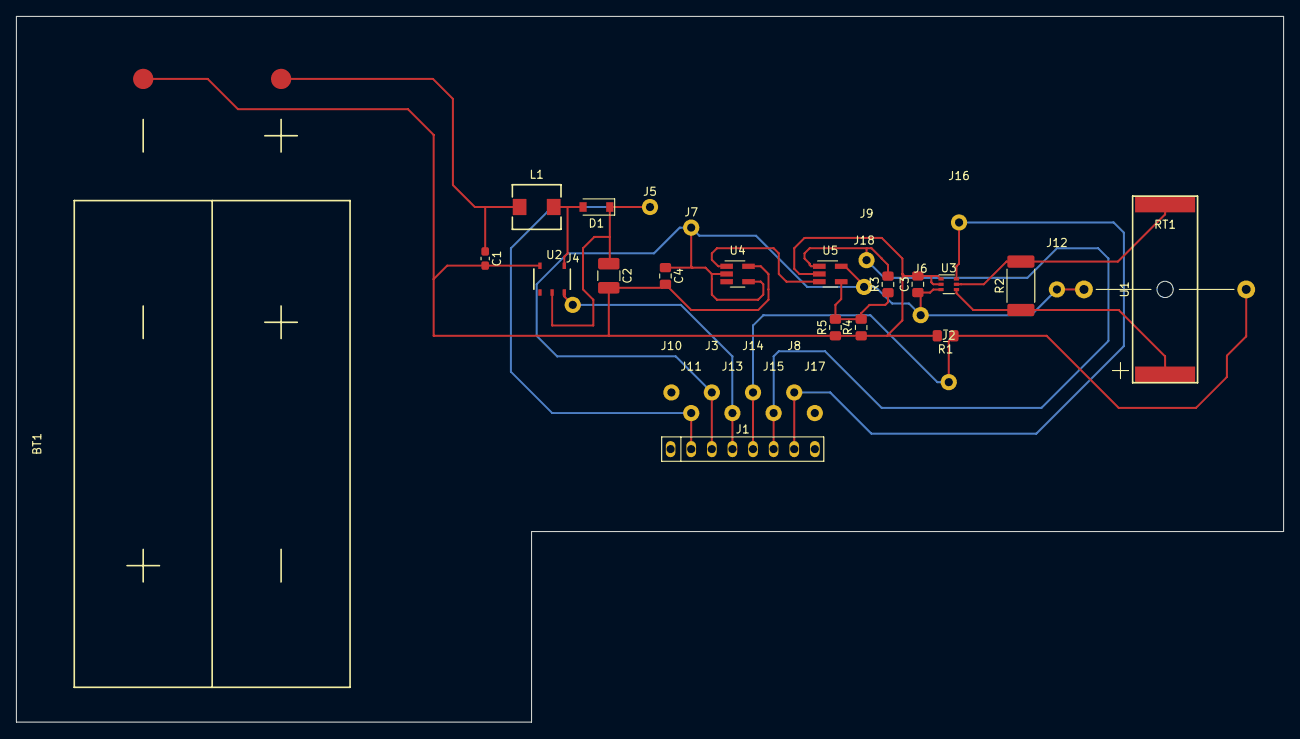
[picture p37: board Prototypedesign1.kicad_pcb from above]

Board: 2 copper layers, 156.2 x 87.0 mm, 36 parts (0 on the bottom side), 13 nets.

Other parts of the board:
J10, J17: Via
