BeeTee-EmBed/Icarus/Final Design (Icarus2019)/KiCad Files/FinalDesign/FinalDesign/FinalDesign/FinalDesign.kicad_pcb

## KiCad design Final Design (Icarus2019)/KiCad Files/FinalDesign/FinalDesign/FinalDesign/FinalDesign.kicad_pcb (2019-08-20)

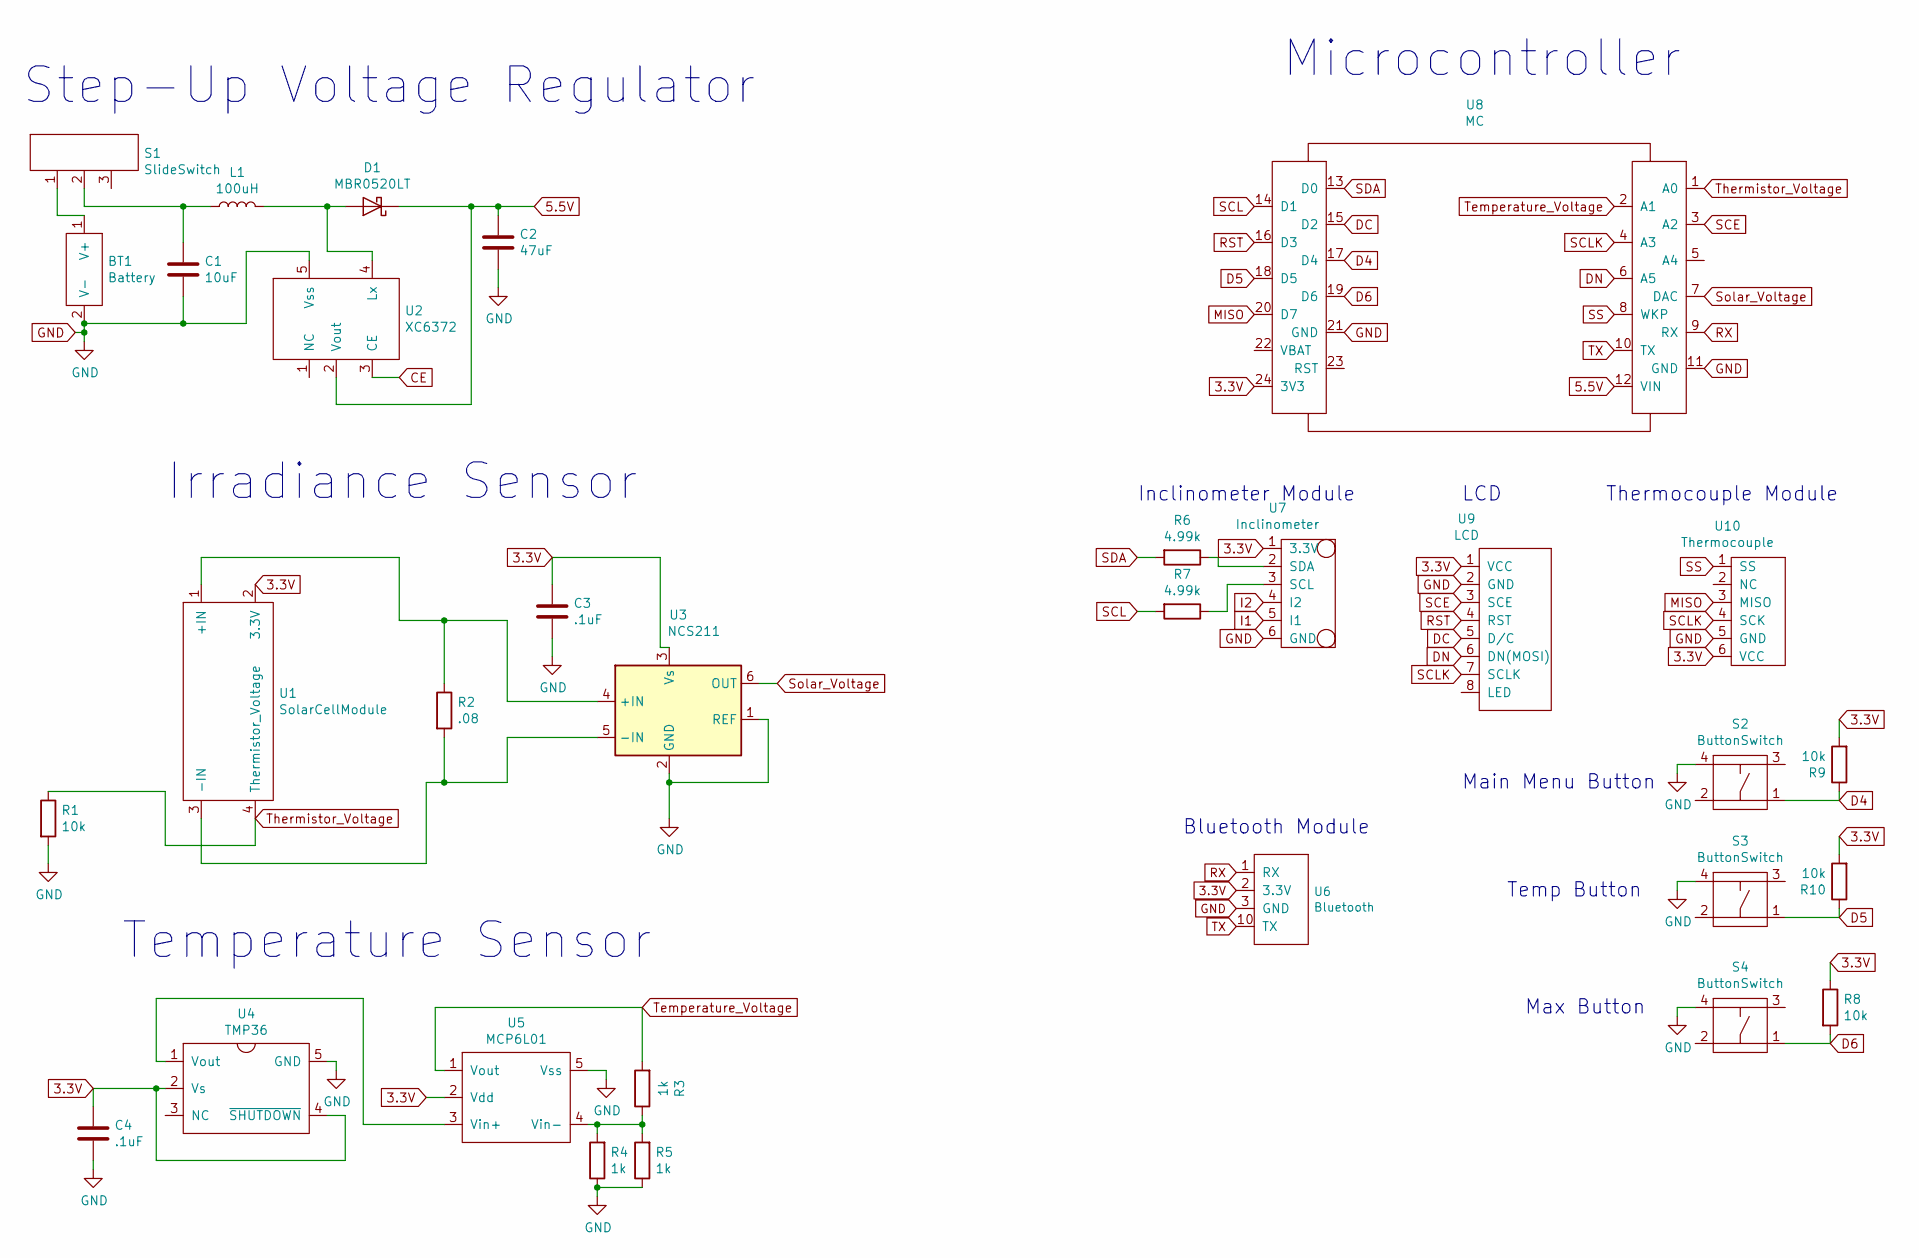
[picture p38: schematic FinalDesign.sch, Irradiance Final Design]

Parts:
BT1: Battery; Prototypebatteryholder
C1: 10uF; C_0603_1608Metric_Pad1.05x0.95mm_HandSolder
C2: 47uF; C_1210_3225Metric_Pad1.42x2.65mm_HandSolder
C3, C4: .1uF; C_0805_2012Metric_Pad1.15x1.40mm_HandSolder
D1: MBR0520LT; D_SOD-123
L1: 100uH; Inductor100uH
R1, R8, R9, R10: 10k; R_0805_2012Metric_Pad1.15x1.40mm_HandSolder
R2: .08; R_2512_6332Metric_Pad1.52x3.35mm_HandSolder
R3, R4, R5: 1k; R_0805_2012Metric_Pad1.15x1.40mm_HandSolder
R6, R7: 4.99k; R_0805_2012Metric_Pad1.15x1.40mm_HandSolder
S1: SlideSwitch
S2, S3, S4: ButtonSwitch
U1: SolarCellModule; Solar Cell Module
U2: XC6372
U3: NCS211; SOT-363_SC-70-6
U4: TMP36; SOT-23-5_HandSoldering-TMP36
U5: MCP6L01; SOT-23-5_HandSoldering-MCP6L01
U6: Bluetooth
U7: Inclinometer
U8: MC
U9: LCD
U10: Thermocouple

Connections:
3.3V: C3.1, C4.1, R8.1, R9.2, R10.2, U1.2 (3.3V), U3.3 (Vs), U4.2 (Vs), U4.4 (~SHUTDOWN), U5.2 (Vdd), U6.2 (3.3V), U7.1 (3.3V), U8.24 (3V3), U9.1 (VCC), U10.6 (VCC)
5.5V: C2.1, D1.1 (K), U2.2 (Vout), U8.12 (VIN)
CE: U2.3 (CE)
D4: R9.1, S2.1, U8.17 (D4)
D5: R10.1, S3.1, U8.18 (D5)
D6: R8.2, S4.1, U8.19 (D6)
DC: U8.15 (D2), U9.5 (D/C)
DN: U8.6 (A5), U9.6 (DN(MOSI))
GND: BT1.2 (V-), C1.2, C2.2, C3.2, C4.2, R1.2, R4.1, R5.1, S2.4, S3.4, S4.4, U2.5 (Vss), U3.1 (REF), U3.2 (GND), U4.5 (GND), U5.5 (Vss), U6.3 (GND), U7.6 (GND), U8.11 (GND), U8.21 (GND), U9.2 (GND), U10.5 (GND)
I1: U7.5 (I1)
I2: U7.4 (I2)
MISO: U8.20 (D7), U10.3 (MISO)
unnamed: BT1.1 (V+), S1.1
unnamed: C1.1, L1.1, S1.2
unnamed: D1.2 (A), L1.2, U2.4 (Lx)
unnamed: R2.1, U1.1 (+IN), U3.4 (+IN)
unnamed: R2.2, U1.3 (-IN), U3.5 (-IN)
unnamed: R3.1, R4.2, R5.2, U5.4 (Vin-)
unnamed: R6.1, U7.2 (SDA)
unnamed: R7.1, U7.3 (SCL)
unnamed: U4.1 (Vout), U5.3 (Vin+)
RST: U8.16 (D3), U9.4 (RST)
RX: U6.1 (RX), U8.9 (RX)
SCE: U8.3 (A2), U9.3 (SCE)
SCL: R7.2, U8.14 (D1)
SCLK: U8.4 (A3), U9.7 (SCLK), U10.4 (SCK)
SDA: R6.2, U8.13 (D0)
SS: U8.8 (WKP), U10.1 (SS)
Solar_Voltage: U3.6 (OUT), U8.7 (DAC)
TX: U6.10 (TX), U8.10 (TX)
Temperature_Voltage: R3.2, U5.1 (Vout), U8.2 (A1)
Thermistor_Voltage: R1.1, U1.4 (Thermistor_Voltage), U8.1 (A0)

Notes on the sheet:
Step-Up Voltage Regulator
Temperature Sensor
Irradiance Sensor
Main Menu Button
Temp Button
Max Button
Bluetooth Module
Thermocouple Module
LCD
Microcontroller
Inclinometer Module

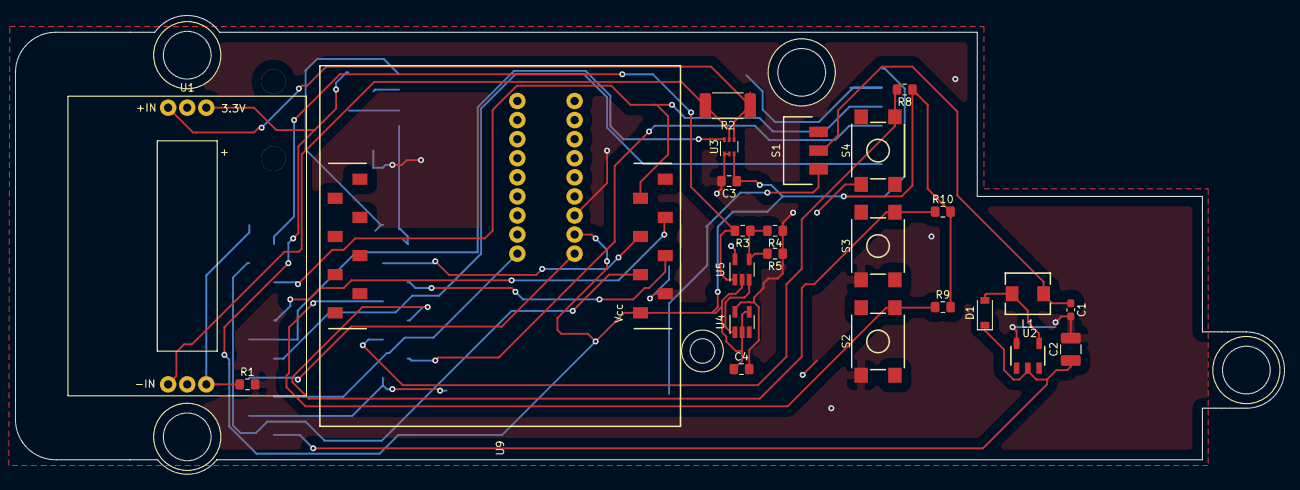
[picture p39: board FinalDesign.kicad_pcb from above]

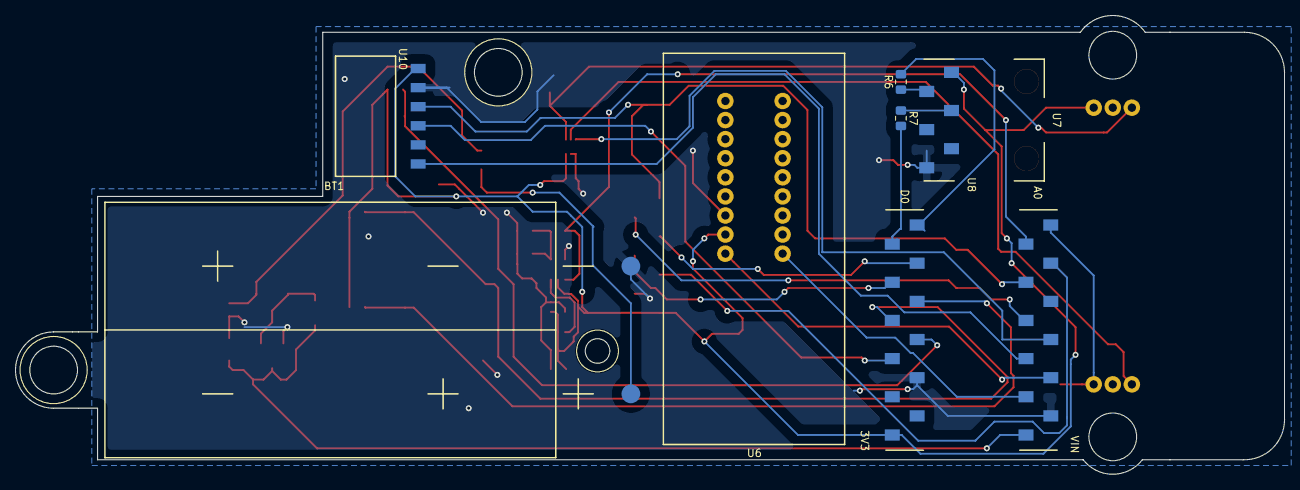
[picture p40: board FinalDesign.kicad_pcb from below]

Board: 2 copper layers, 168.9 x 61.1 mm, 31 parts (7 on the bottom side), 29 nets.
