BeeTee-EmBed/Icarus/Final Design (Icarus2019)/KiCad Files/FinalDesign/FinalDesign/FinalDesign/solarcell/solarcell.kicad_pcb

## KiCad design Final Design (Icarus2019)/KiCad Files/FinalDesign/FinalDesign/FinalDesign/solarcell/solarcell.kicad_pcb (2019-08-20)

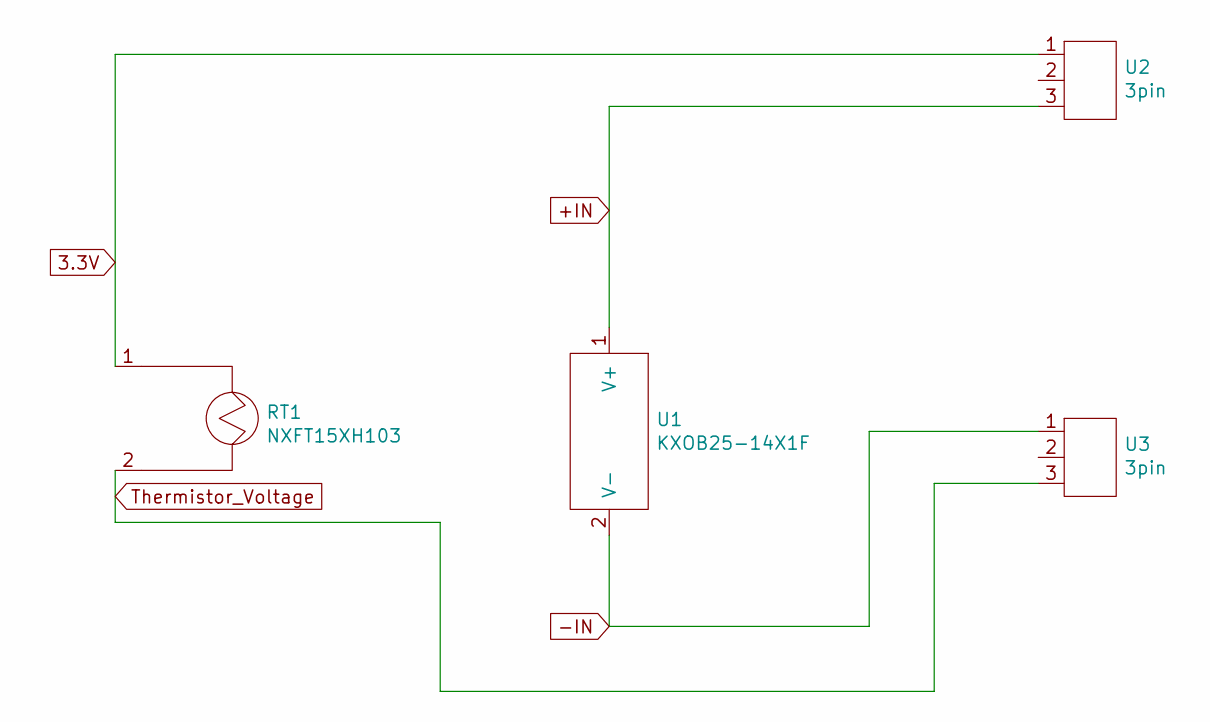
[picture p41: schematic solarcell.sch]

Parts:
RT1: NXFT15XH103; Thermistor2
U1: KXOB25-14X1F; KXOB25
U2, U3: 3pin

Connections:
3.3V: RT1.1, U2.1
+IN: U1.1 (V+), U2.3
-IN: U1.2 (V-), U3.1
Thermistor_Voltage: RT1.2, U3.3

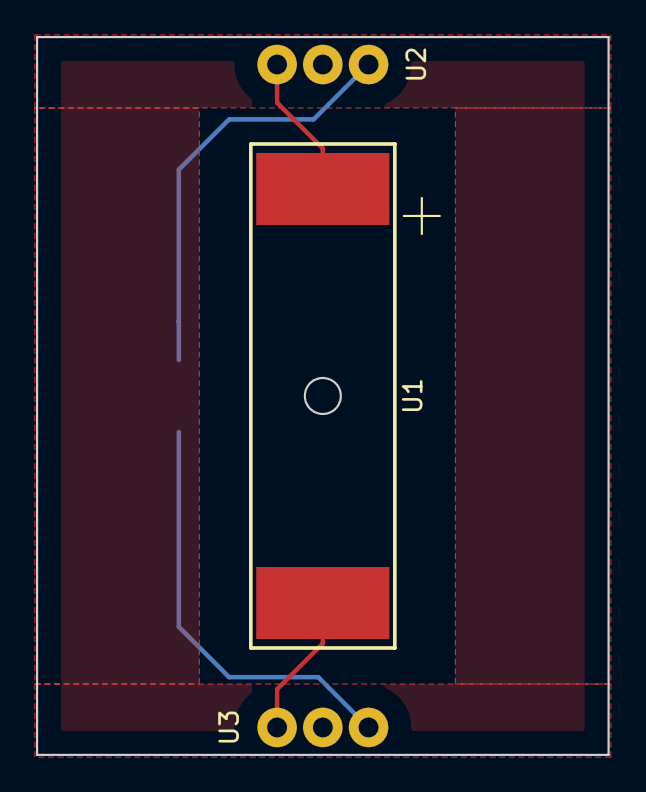
[picture p42: board solarcell.kicad_pcb from above]

Board: 2 copper layers, 31.8 x 39.9 mm, 4 parts (1 on the bottom side), 4 nets.
