BeeTee-EmBed/Icarus/(commit log)

2019-08-02 Modified the bit shift in the short circuit function
    [icarus-main.ino]
2019-08-02 Added a rolling average for the solar cell voltage, to smooth irradiance readings
2019-08-05 Modified sampling rate to speed up rolling median filter response
2019-08-05 Fixing delay time for sampling speed
    [icarus-main.ino]
2019-08-09 Altered number of places for irradiance, incline, and ambient temp to account for sensor precision
2019-08-13 Altered setScreen to use enum and switch, replacing if/then statments for the sake of clarity
2019-08-13 Replaced magic numbers with const variables, and reordered global variables for the sake of clarity
    [BLE PCB.kicad_pcb, BLE PCB.sch, DC Combiner Box Sheet.xlsx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]
2019-08-13 magic number variable replacement, and adding degree's sign to output to display
    [icarus-main.ino]
2019-08-13 Changed const variables to upper case to match coding standards
2019-08-15 Added calibration offset
2019-08-15 Adding back file after moving
    [BLE PCB.kicad_pcb, BLE PCB.sch, DC Combiner Box Sheet.xlsx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]
2019-08-19 Modified SMA filter to not use median and not sort array each cycle
2019-08-20 Adding all network files
    [BLE PCB.kicad_pcb, BLE PCB.sch, DC Combiner Box Sheet.xlsx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]
2019-08-23 Added a zero-ing equation for the accelerometer object, to make the initial starting plane the zero degree plane
2019-08-29 Chaznged comment formats to adhere to coding standards including to-do, and changed equation to use calibration offset variable, not a magic number
